deltarobotone/conveyor_system/Drawings/PNG/CarryFront.png

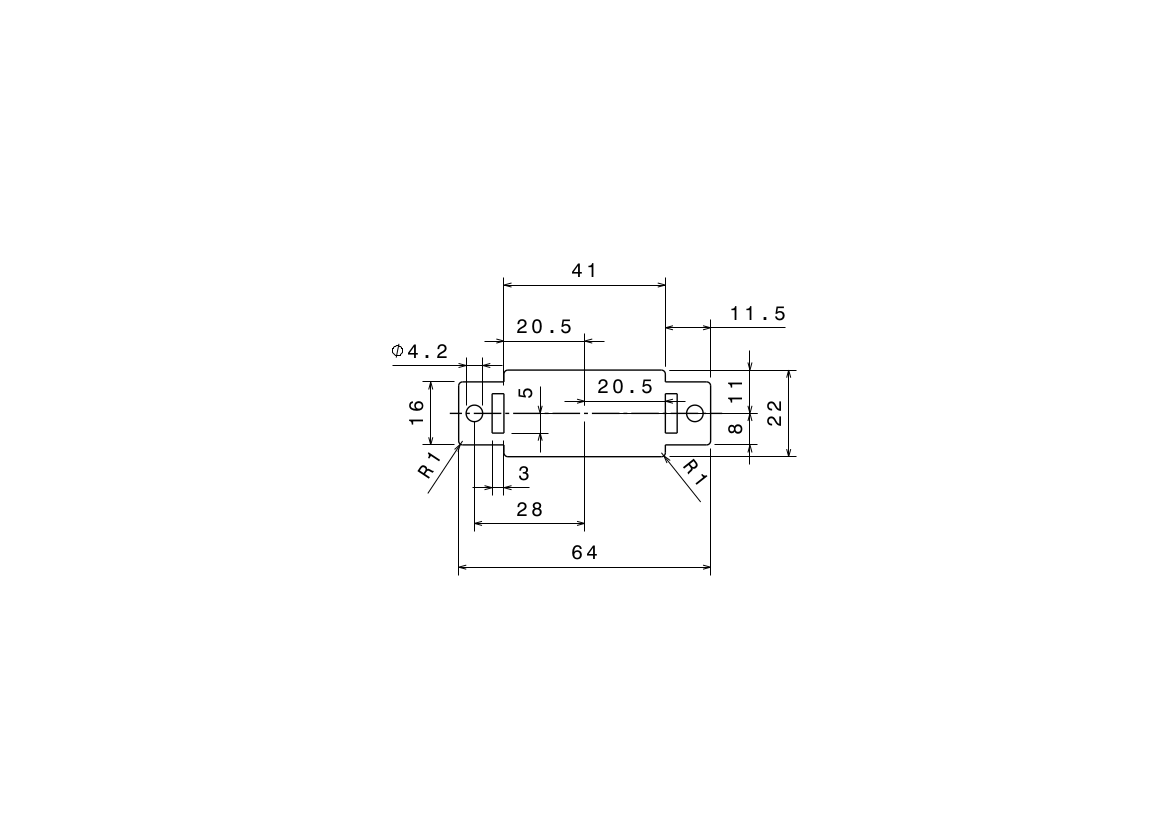
Drawings/PNG/CarryFront.png
