deltarobotone/conveyor_system/Drawings/PNG/CarrySide.png

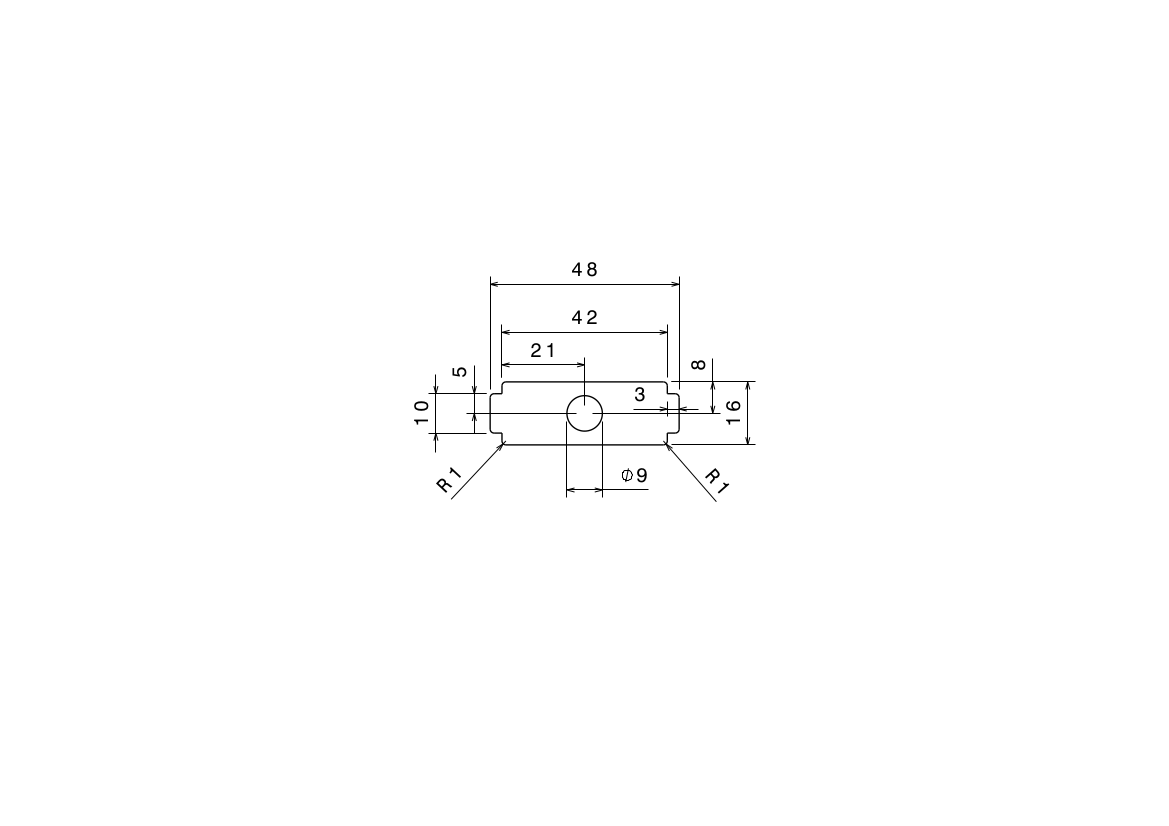
Drawings/PNG/CarrySide.png
