deltarobotone/conveyor_system/Drawings/PNG/ConveyorLayer_1.png

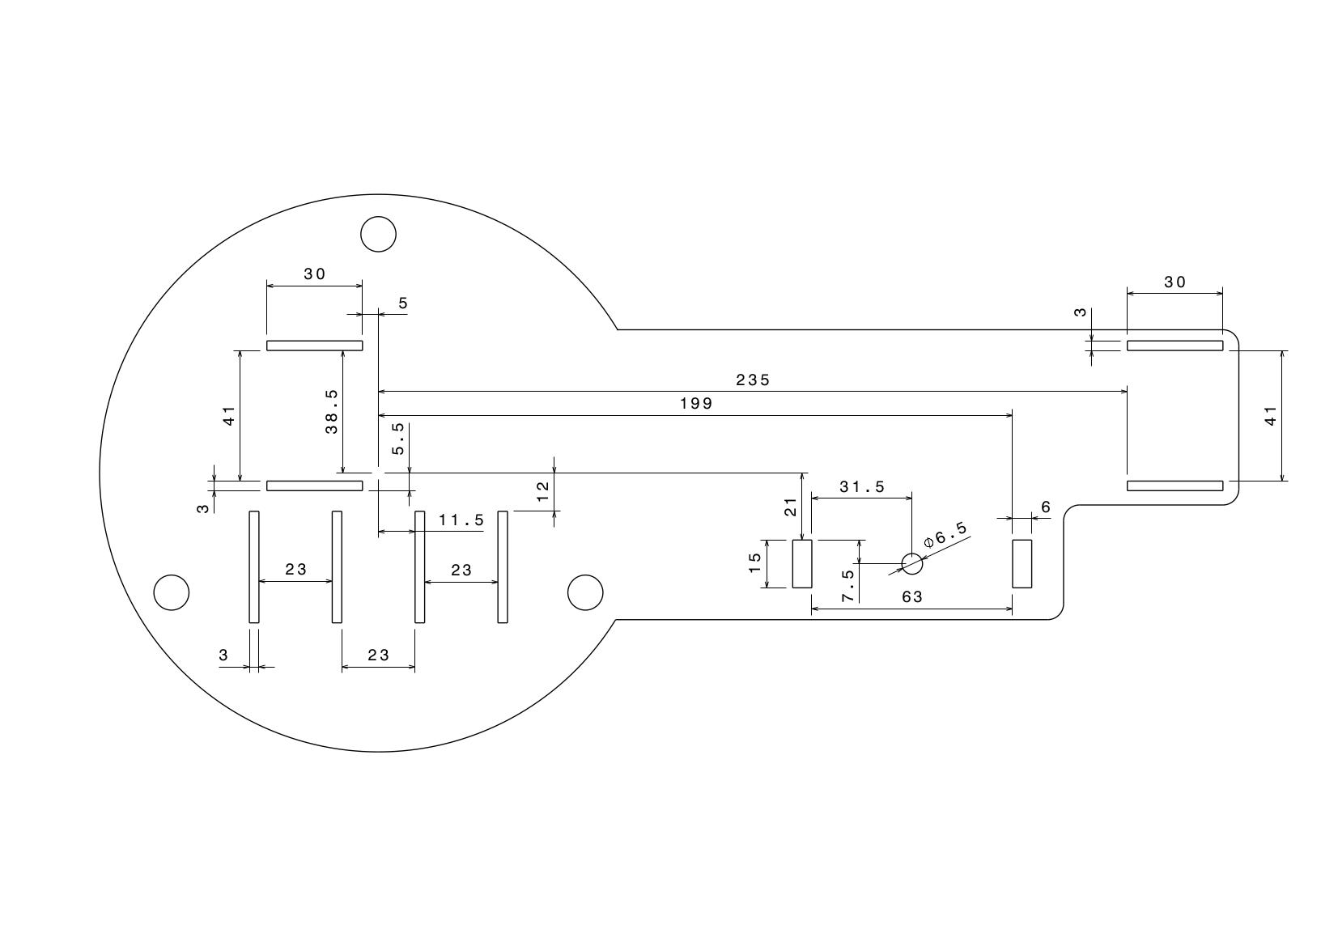
Drawings/PNG/ConveyorLayer_1.png
