deltarobotone/conveyor_system/Drawings/PNG/ConveyorLayer_2.png

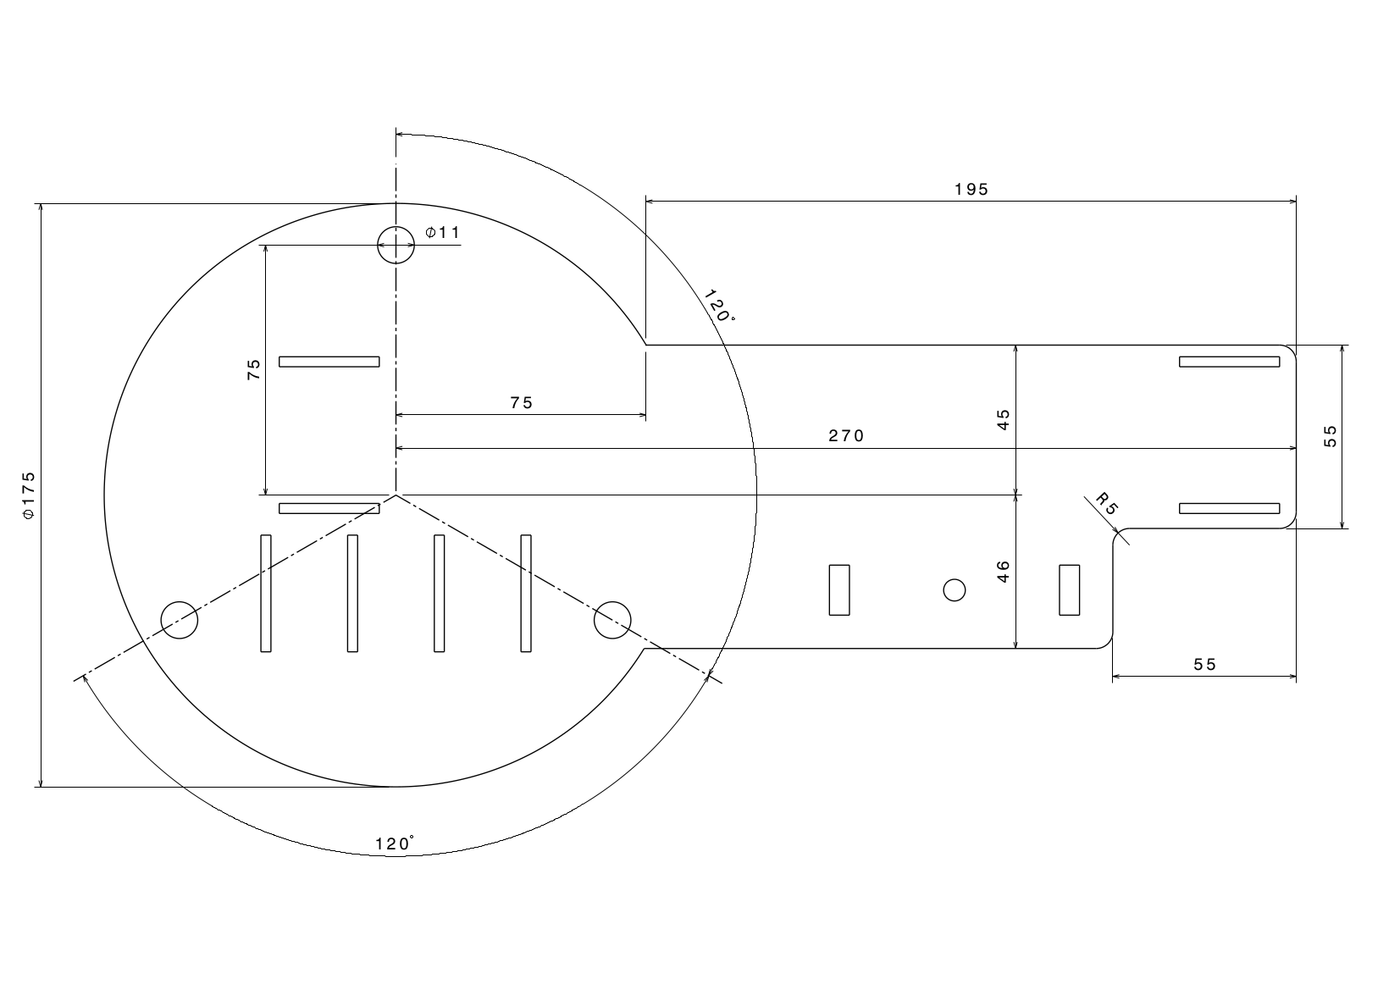
Drawings/PNG/ConveyorLayer_2.png
