deltarobotone/conveyor_system/Drawings/PNG/Drum.png

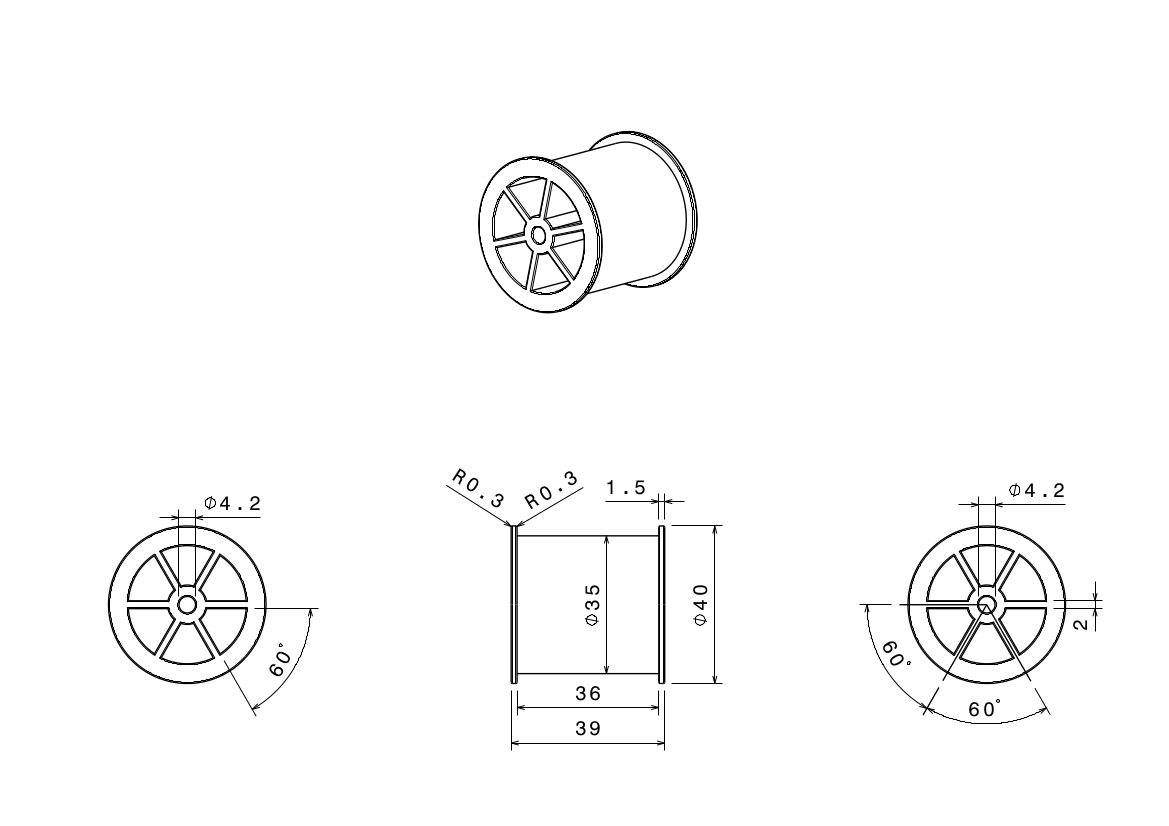
Drawings/PNG/Drum.png
