deltarobotone/conveyor_system/Drawings/PNG/DrumDrive.png

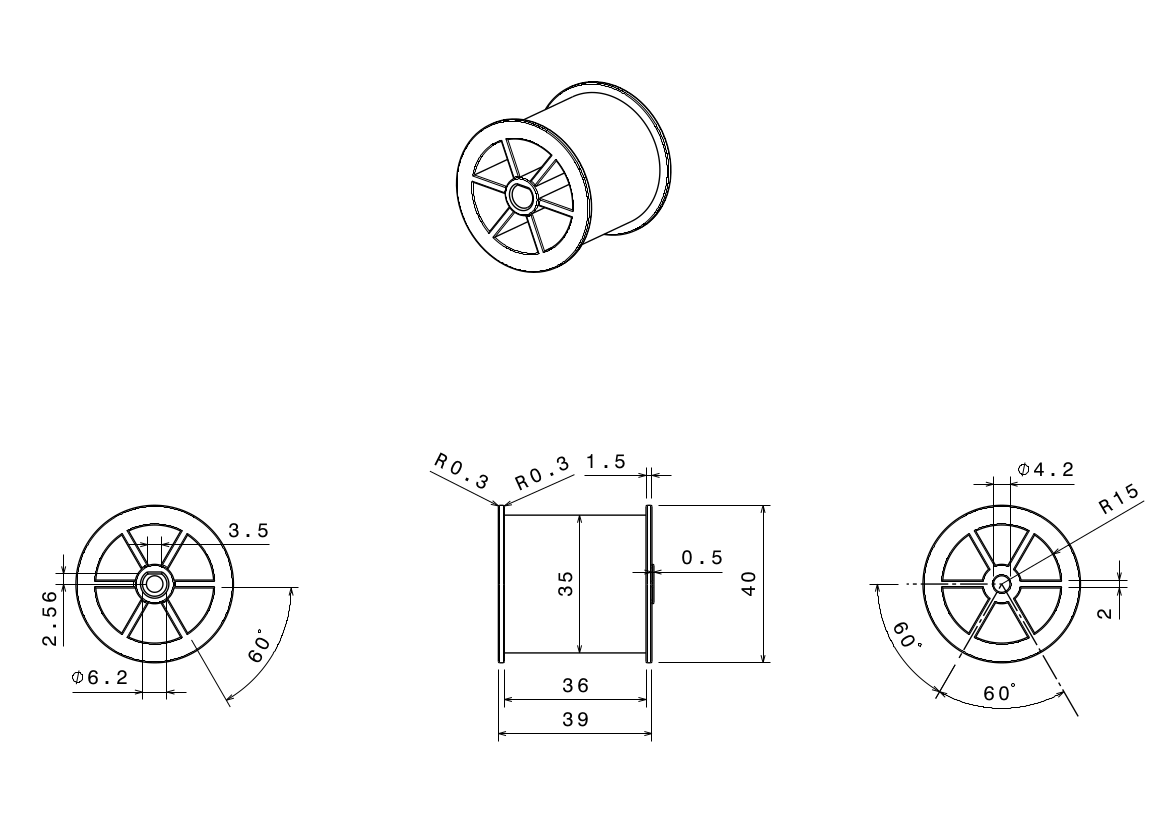
Drawings/PNG/DrumDrive.png
