deltarobotone/conveyor_system/Drawings/PNG/FrameDriveSide_1.png

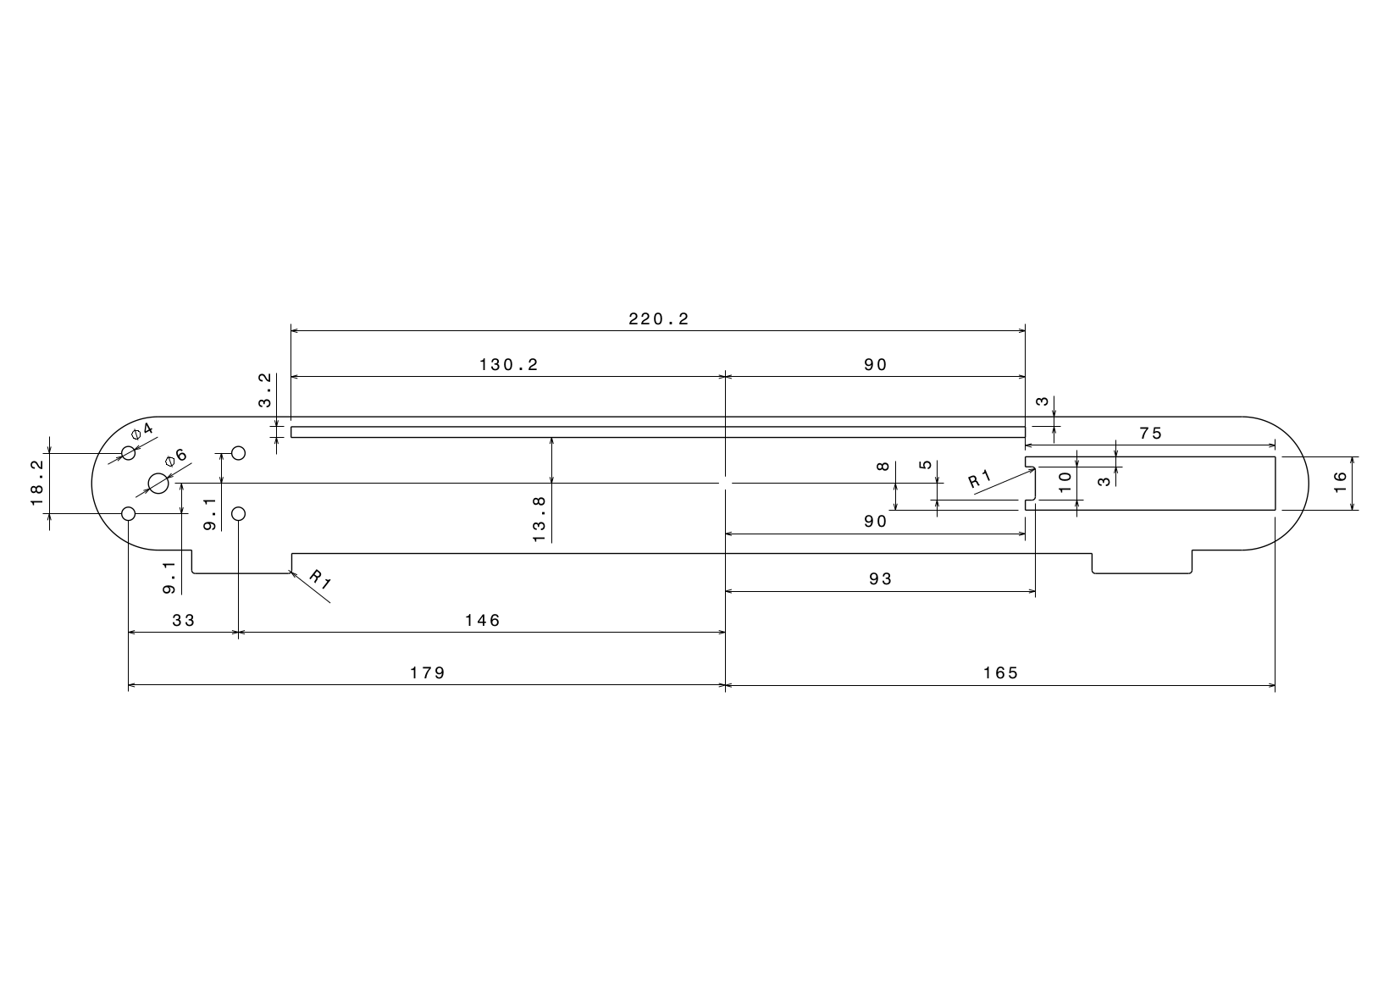
Drawings/PNG/FrameDriveSide_1.png
