deltarobotone/conveyor_system/Drawings/PNG/FrameDriveSide_2.png

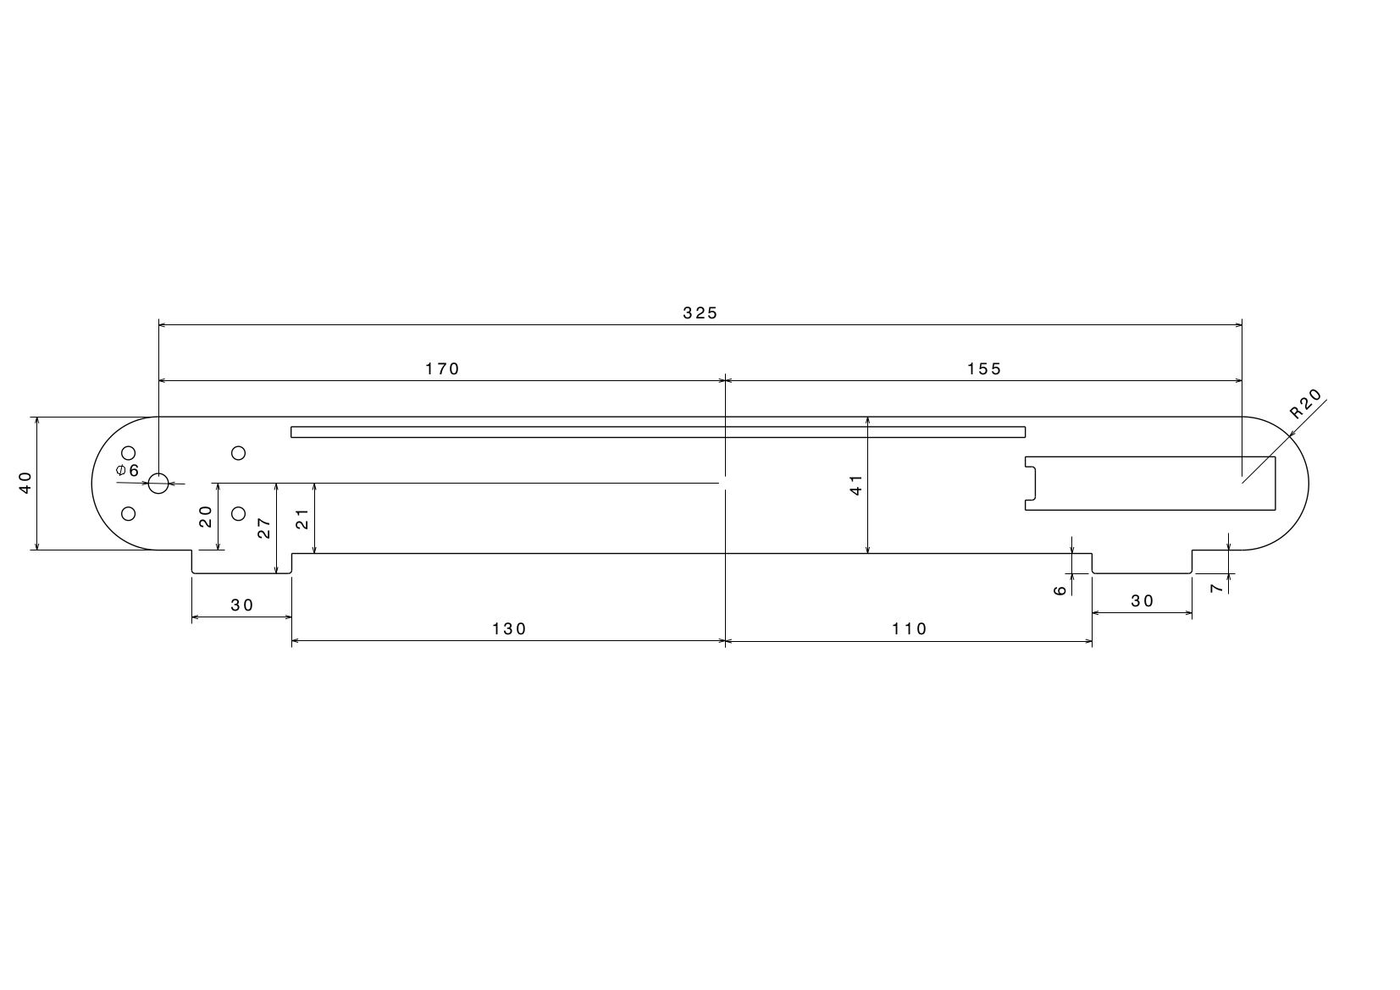
Drawings/PNG/FrameDriveSide_2.png
