deltarobotone/conveyor_system/Drawings/PNG/FrameSide_1.png

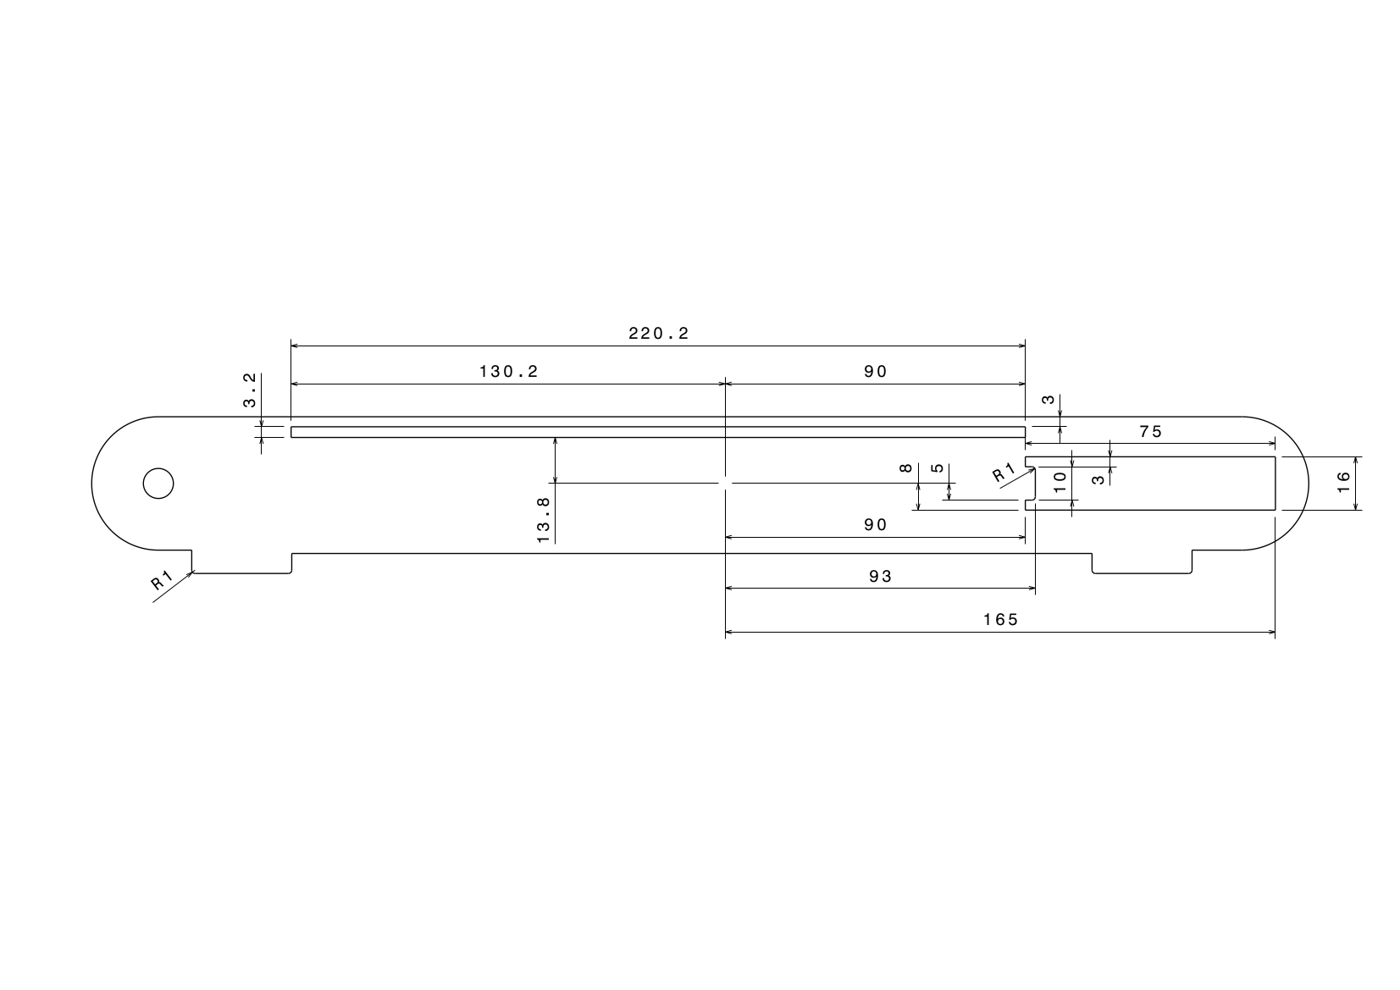
Drawings/PNG/FrameSide_1.png
