deltarobotone/conveyor_system/Drawings/PNG/FrameTop.png

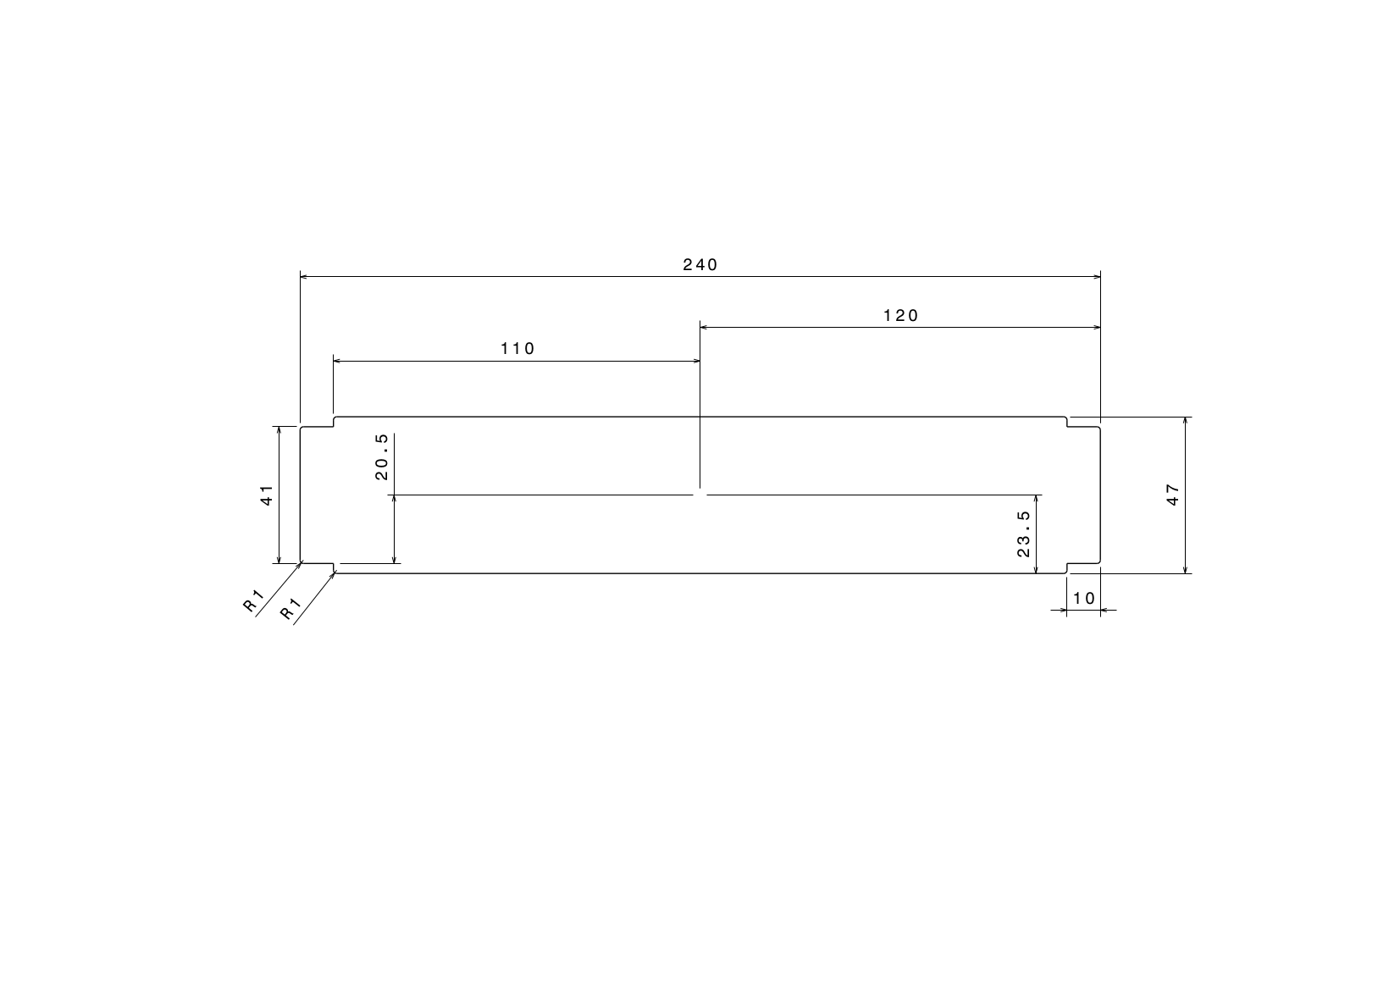
Drawings/PNG/FrameTop.png
