deltarobotone/conveyor_system/Drawings/PNG/Wall.png

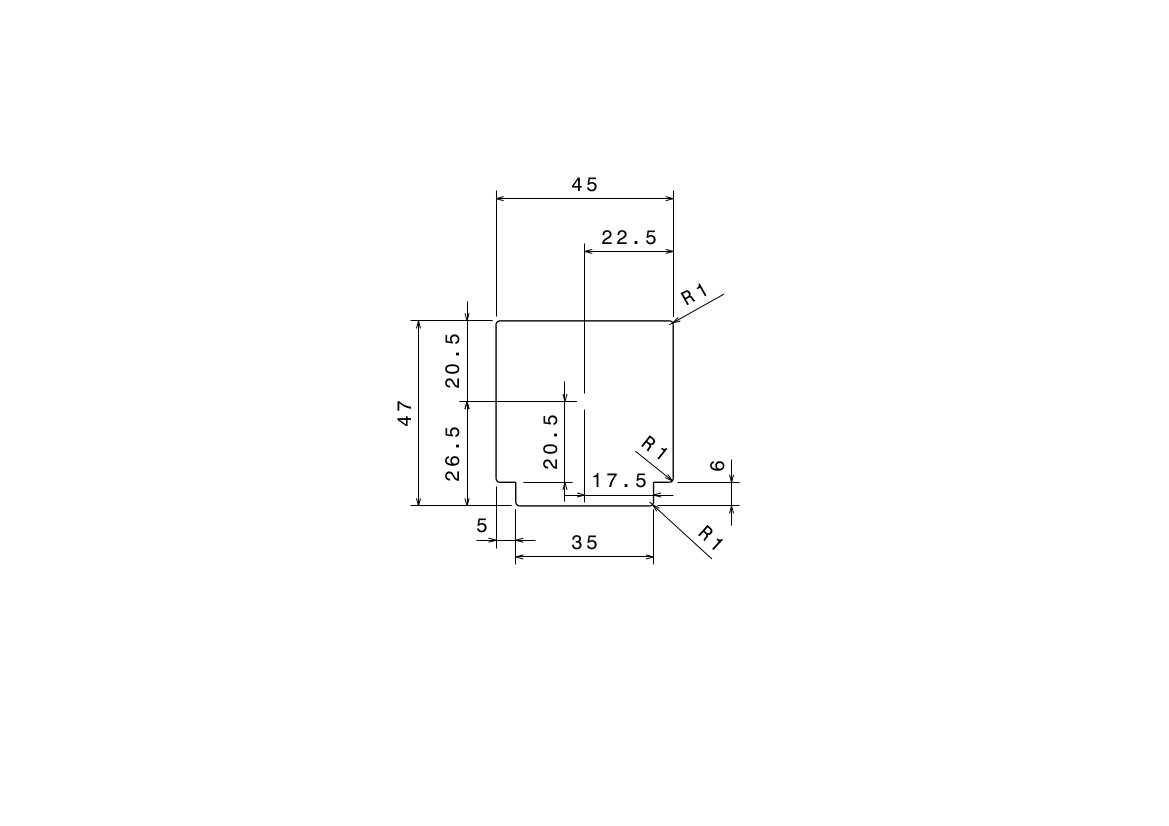
Drawings/PNG/Wall.png
