deltarobotone/conveyor_system/Drawings/PDF/CarryFront.pdf

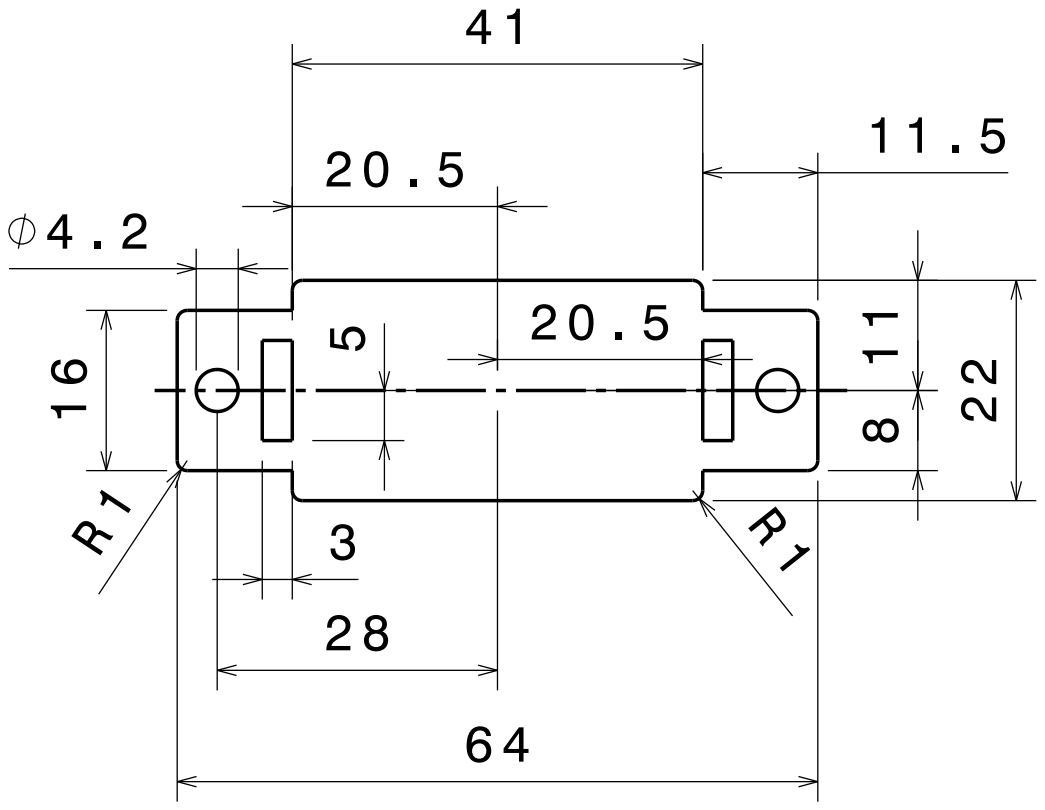
[picture p20: page 1]
