deltarobotone/conveyor_system/Drawings/PDF/CarrySide.pdf

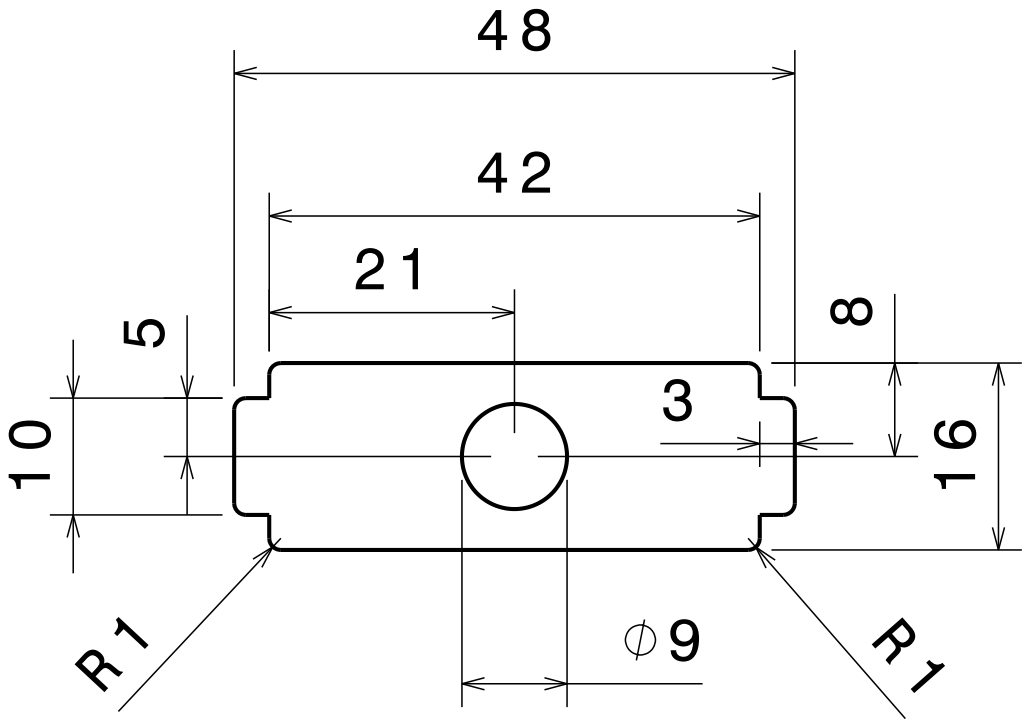
[picture p21: page 1]
