deltarobotone/conveyor_system/Drawings/PDF/ConveyorLayer_1.pdf

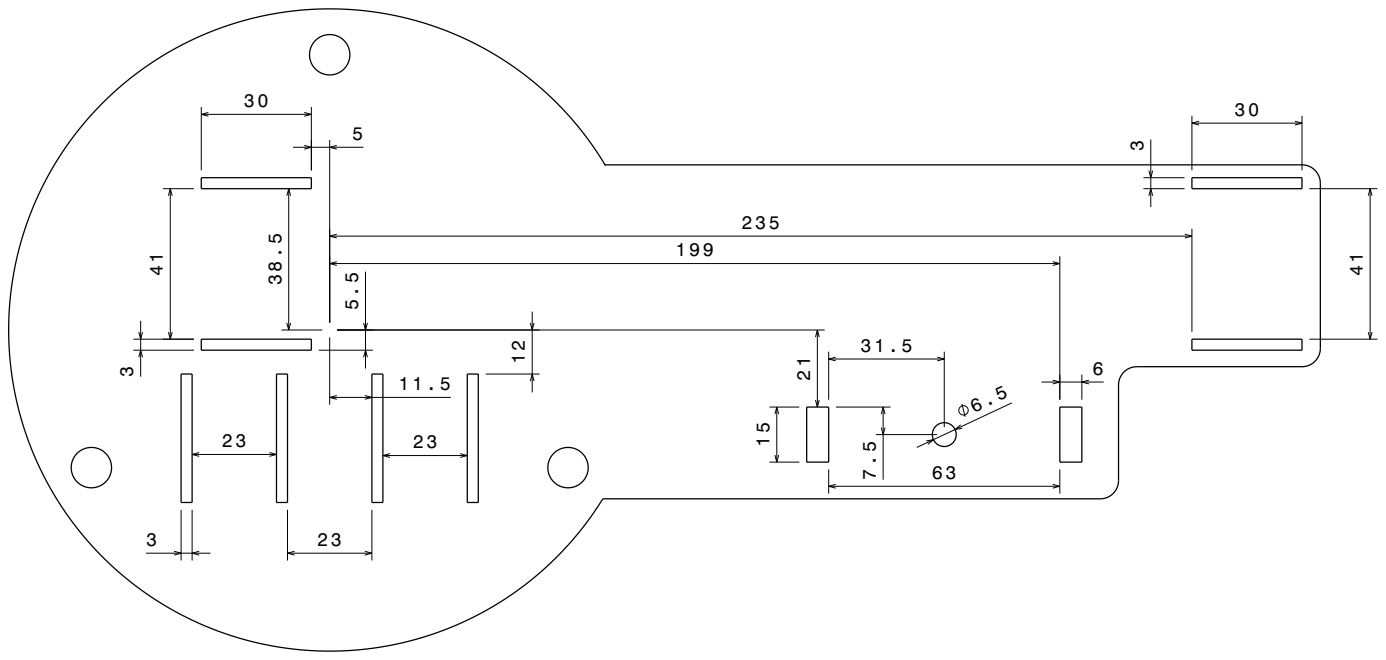
[picture p22: page 1]
