deltarobotone/conveyor_system/Drawings/PDF/ConveyorLayer_2.pdf

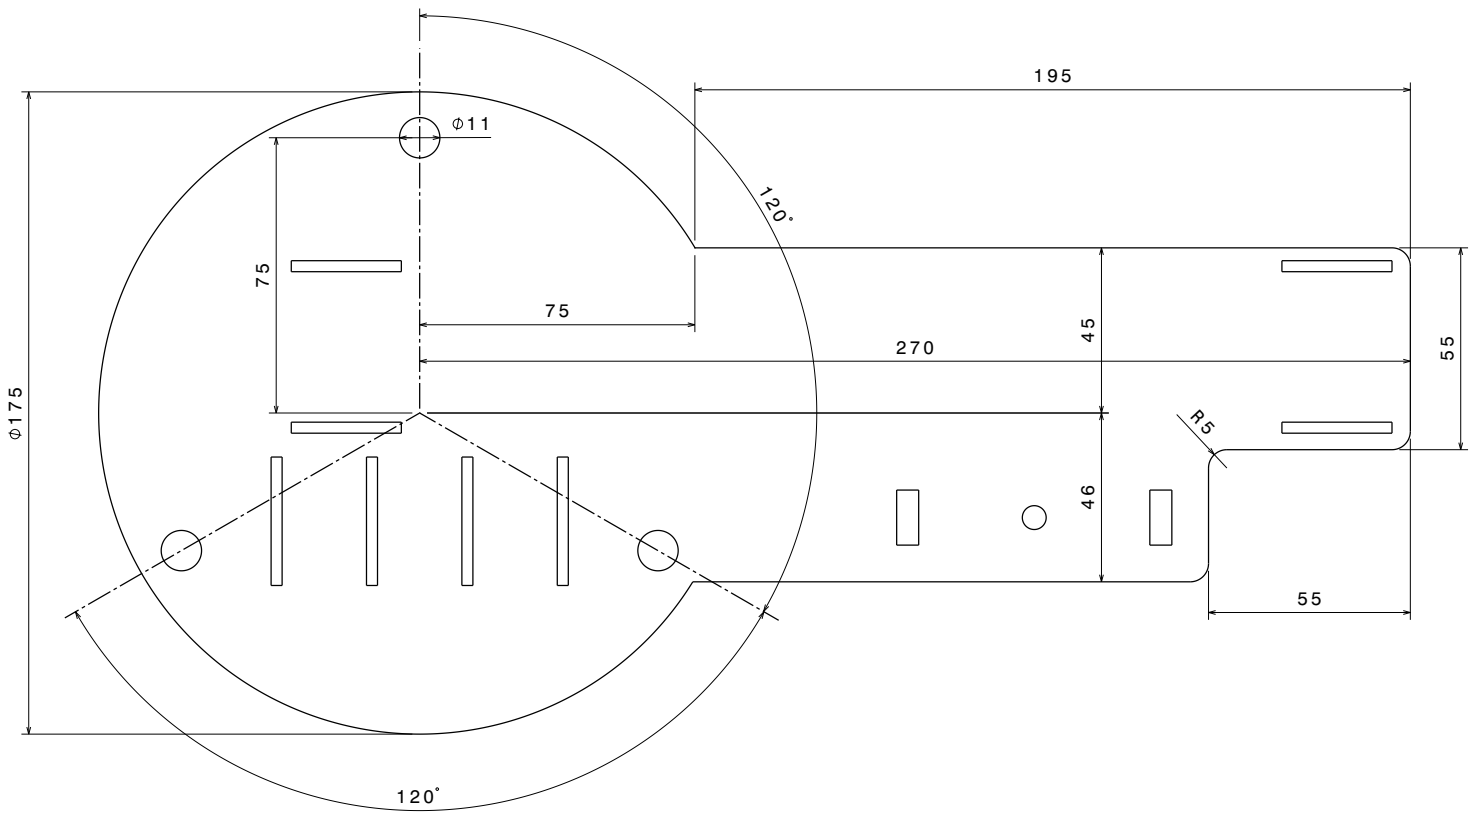
[picture p23: page 1]
