deltarobotone/conveyor_system/Drawings/PDF/Drum.pdf

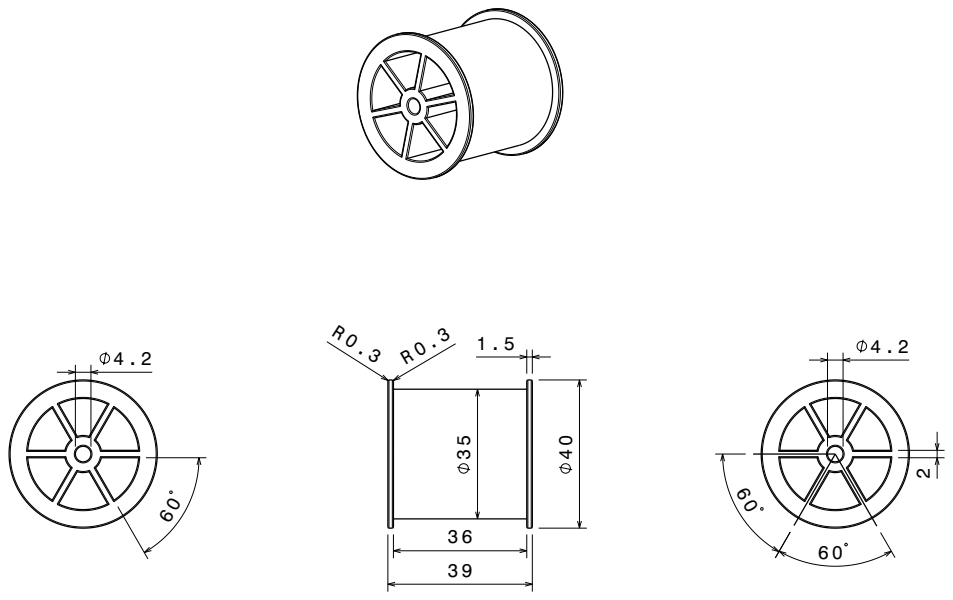
[picture p24: page 1]
