deltarobotone/conveyor_system/Drawings/PDF/DrumDrive.pdf

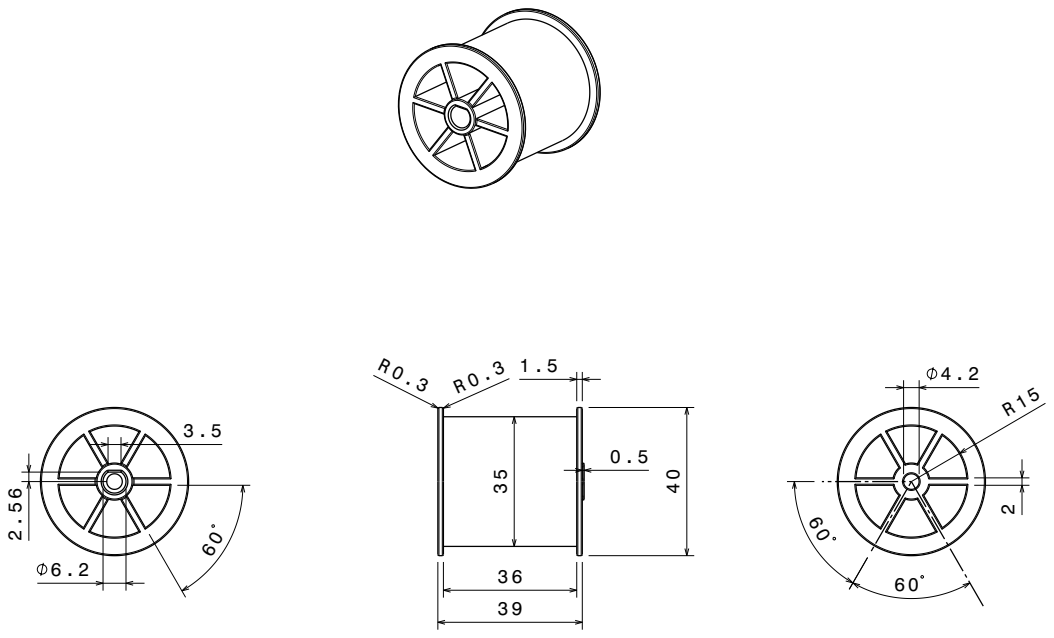
[picture p25: page 1]
