deltarobotone/conveyor_system/Drawings/PDF/FrameDriveSide_1.pdf

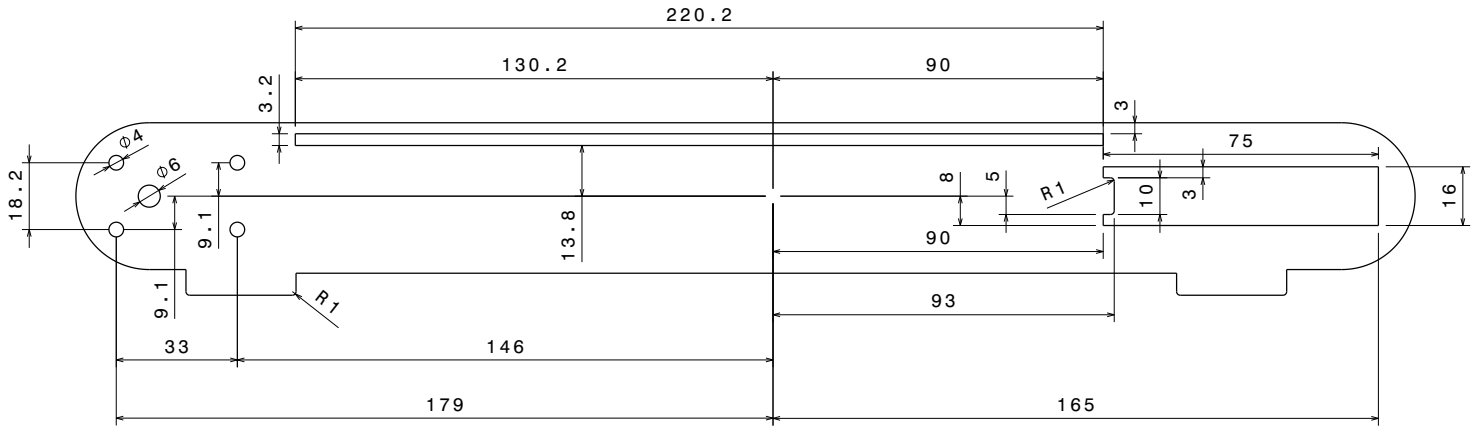
[picture p26: page 1]
