deltarobotone/conveyor_system/Drawings/PDF/FrameDriveSide_2.pdf

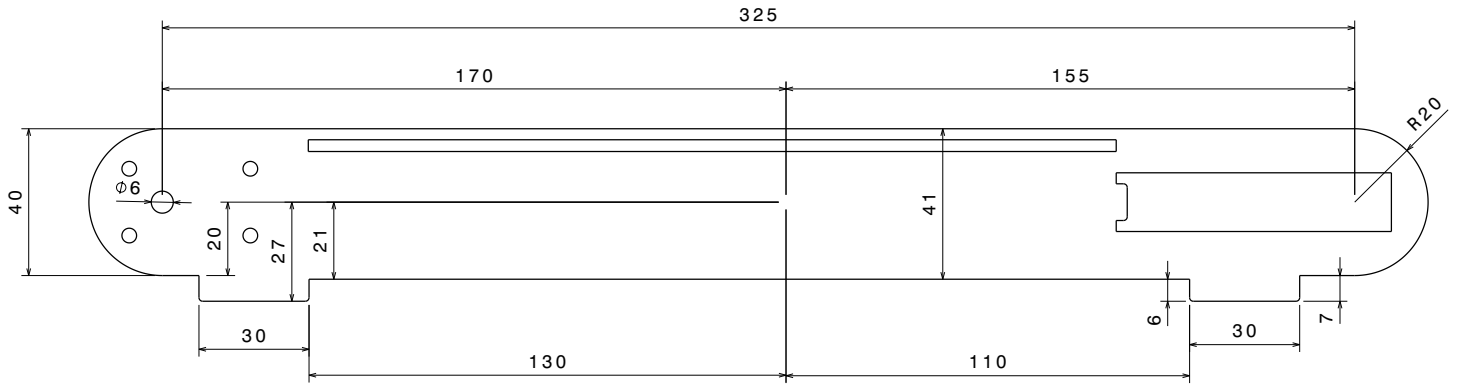
[picture p27: page 1]
