deltarobotone/conveyor_system/Drawings/PDF/FrameSide_1.pdf

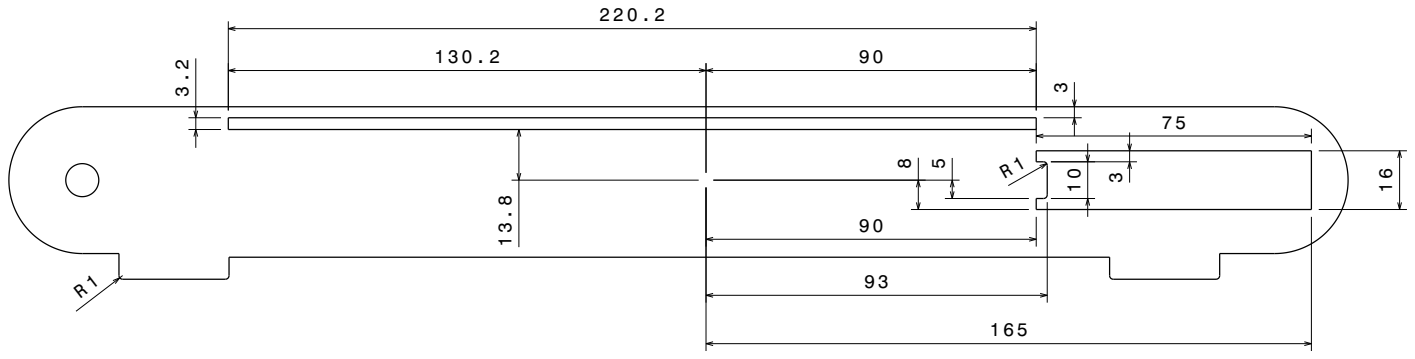
[picture p28: page 1]
