deltarobotone/conveyor_system/Drawings/PDF/FrameSide_2.pdf

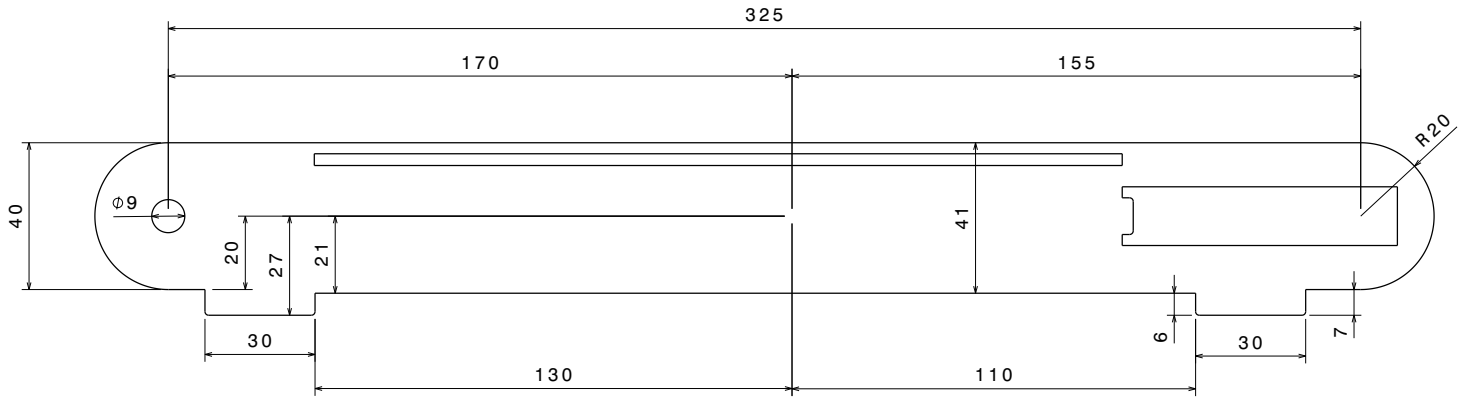
[picture p29: page 1]
