deltarobotone/conveyor_system/Drawings/PDF/FrameTop.pdf

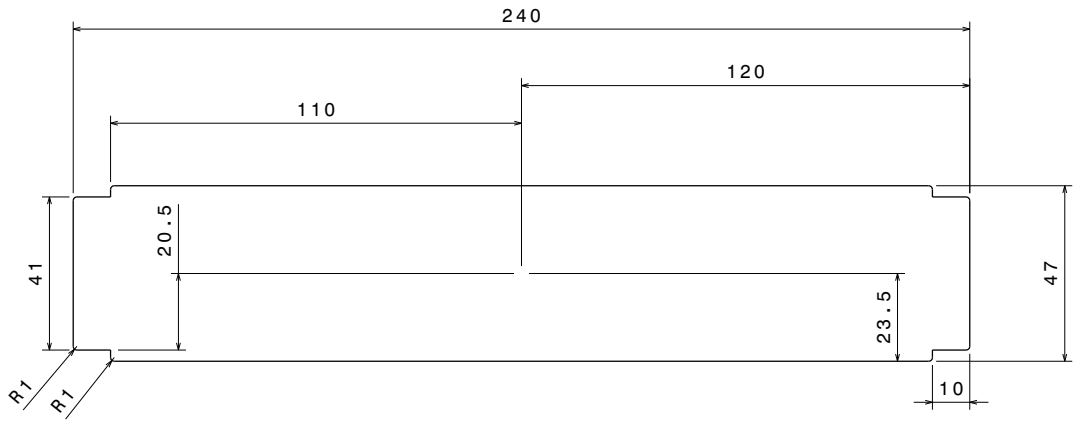
[picture p30: page 1]
