deltarobotone/conveyor_system/Drawings/PDF/Wall.pdf

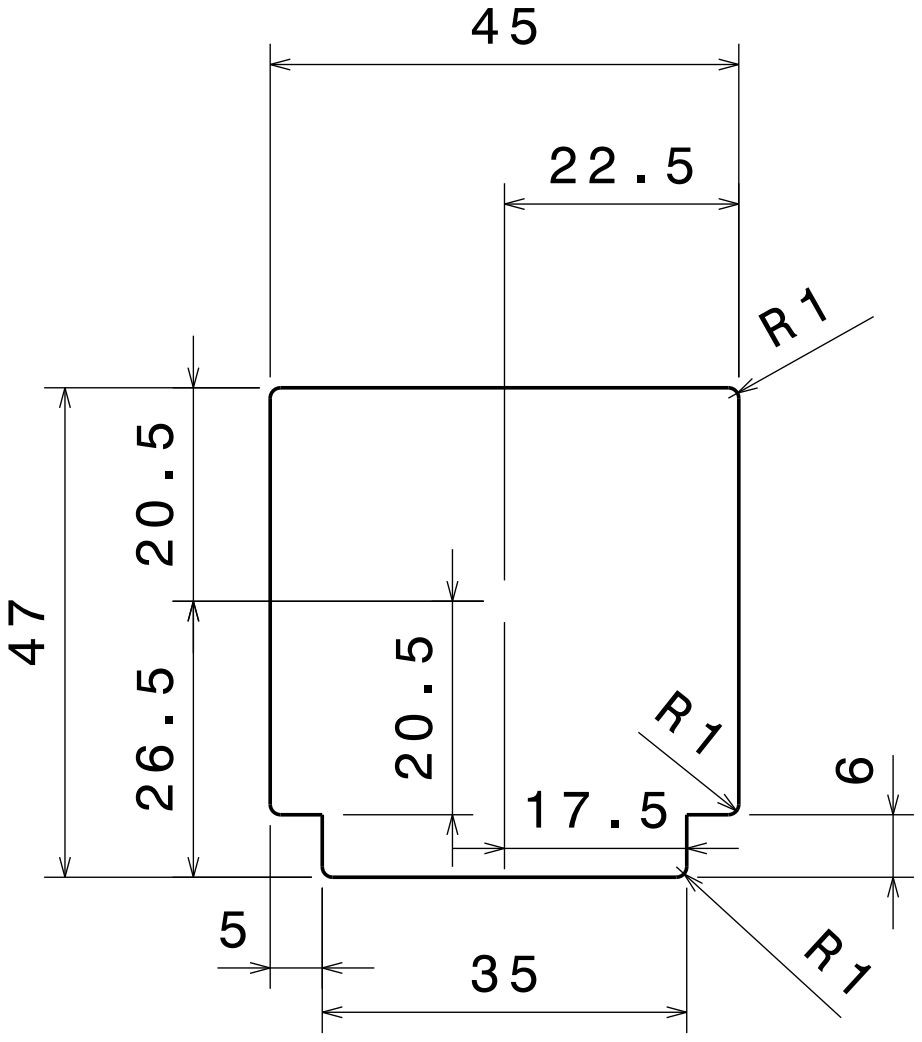
[picture p31: page 1]
