deltarobotone/conveyor_system/Lasercut/PDF/0_Conveyor_Layer_6mm.pdf

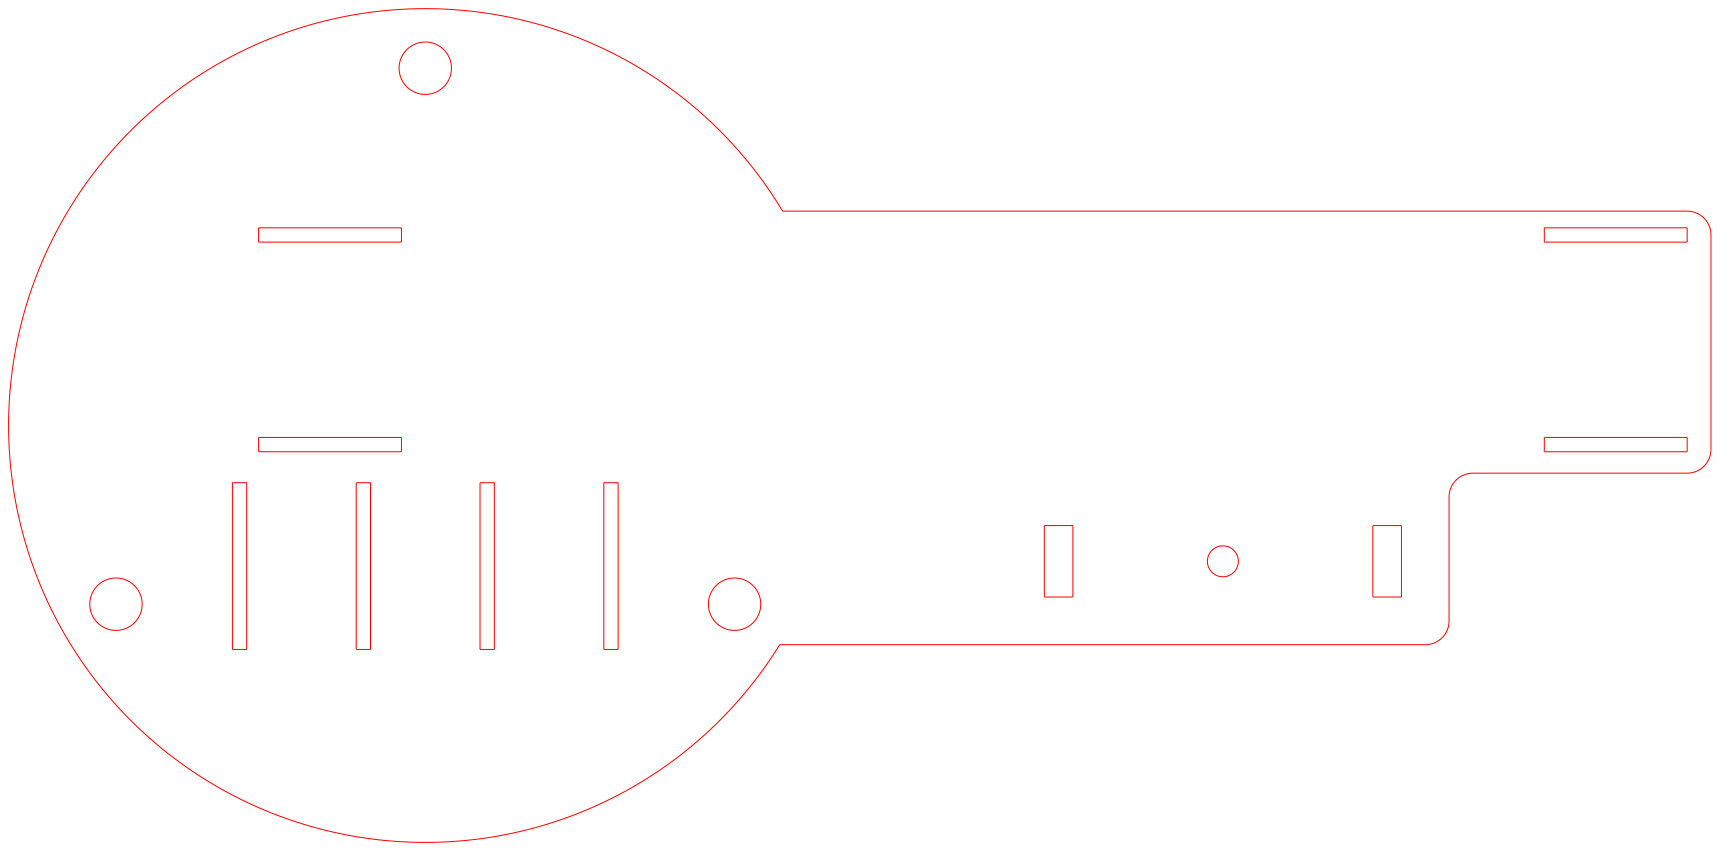
[picture p32: page 1]
