deltarobotone/conveyor_system/Lasercut/PDF/1_Frame_Side_3mm.pdf

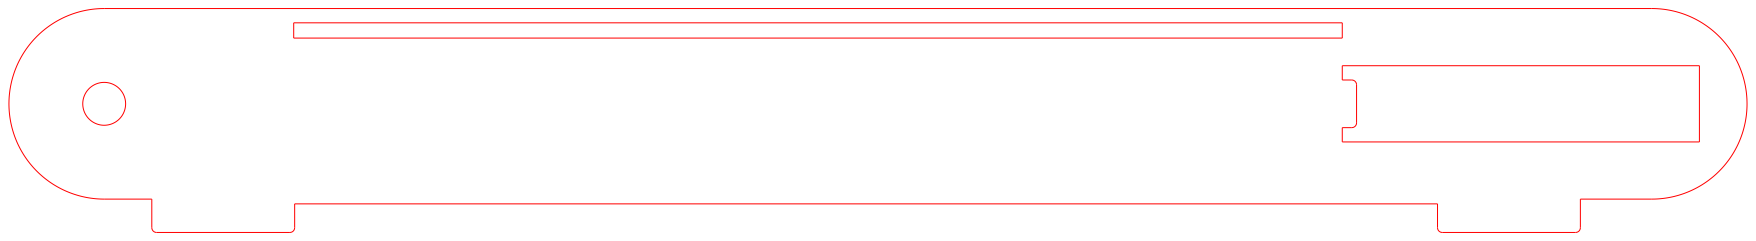
[picture p33: page 1]
