deltarobotone/conveyor_system/Lasercut/PDF/2_Frame_Drive_Side_3mm.pdf

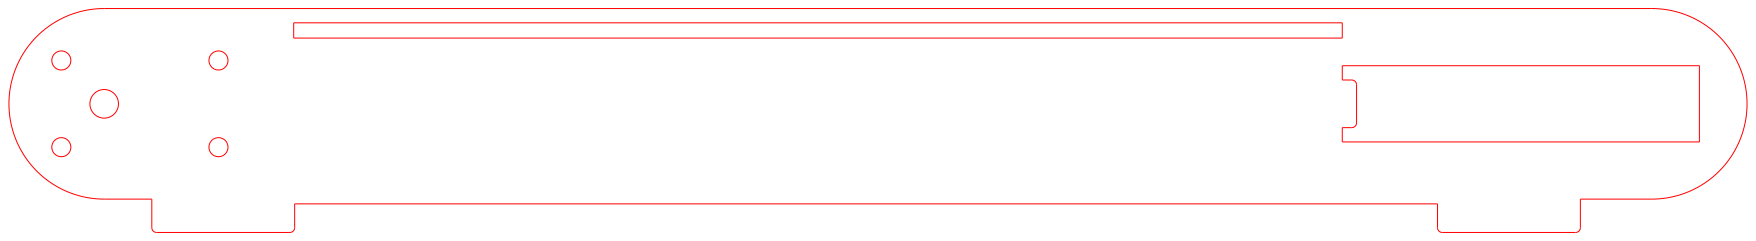
[picture p34: page 1]
