deltarobotone/conveyor_system/Lasercut/PDF/3_Frame_Top_3mm.pdf

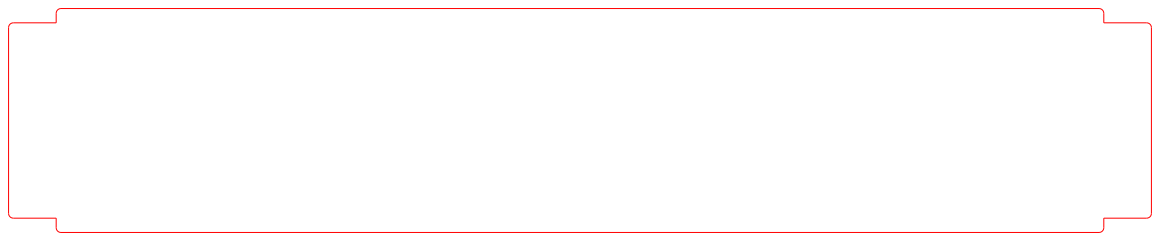
[picture p35: page 1]
