deltarobotone/conveyor_system/Lasercut/PDF/4_Carry_Front_3mm.pdf

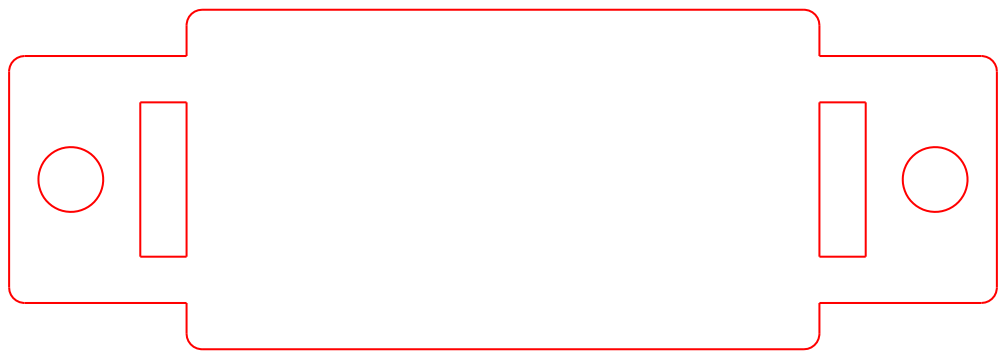
[picture p36: page 1]
