deltarobotone/conveyor_system/Lasercut/PDF/5_Carry_Side_3mm.pdf

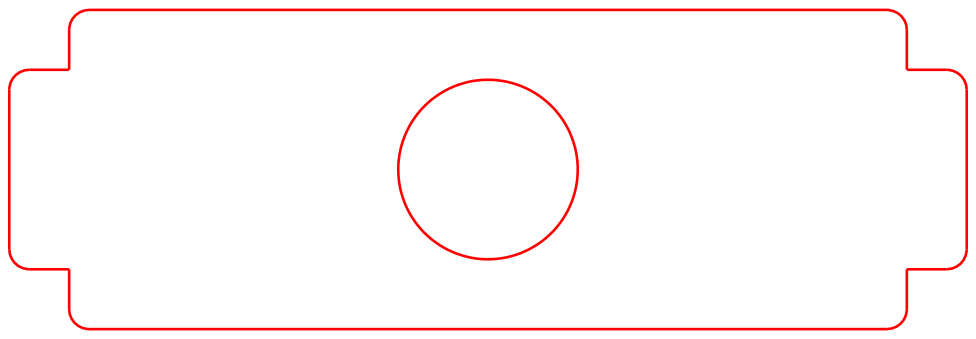
[picture p37: page 1]
