deltarobotone/conveyor_system/Lasercut/PDF/6_Wall_3mm.pdf

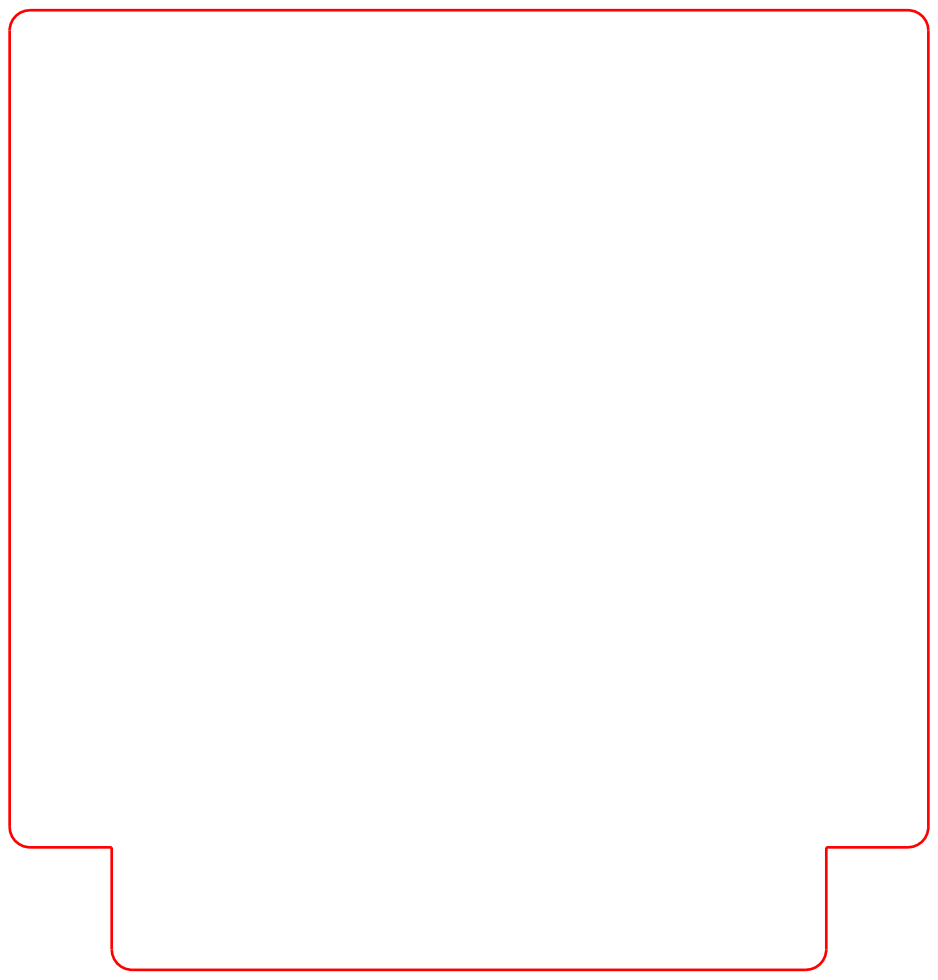
[picture p38: page 1]
