deltarobotone/conveyor_system/3D_Print/Drums/Drum.stl

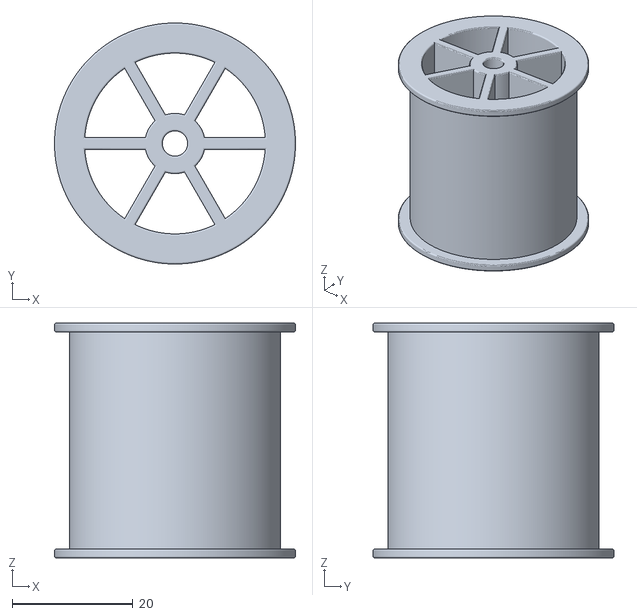
[picture p12: CAD file, 2020-04-07]
3D_Print/Drums/Drum.stl
40.0 x 40.0 x 39.0
