deltarobotone/conveyor_system/Lasercut/STL/1_Frame_Side_3mm.stl

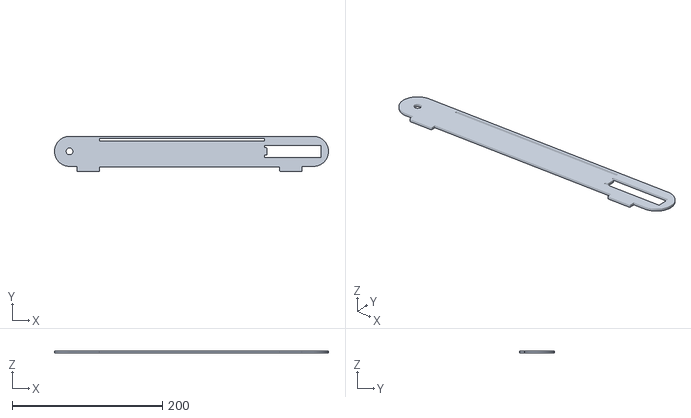
[picture p13: CAD file, 2020-04-07]
Lasercut/STL/1_Frame_Side_3mm.stl
365.0 x 47.0 x 3.00
