deltarobotone/conveyor_system/3D_Print/Drums/Drum_Drive.stl

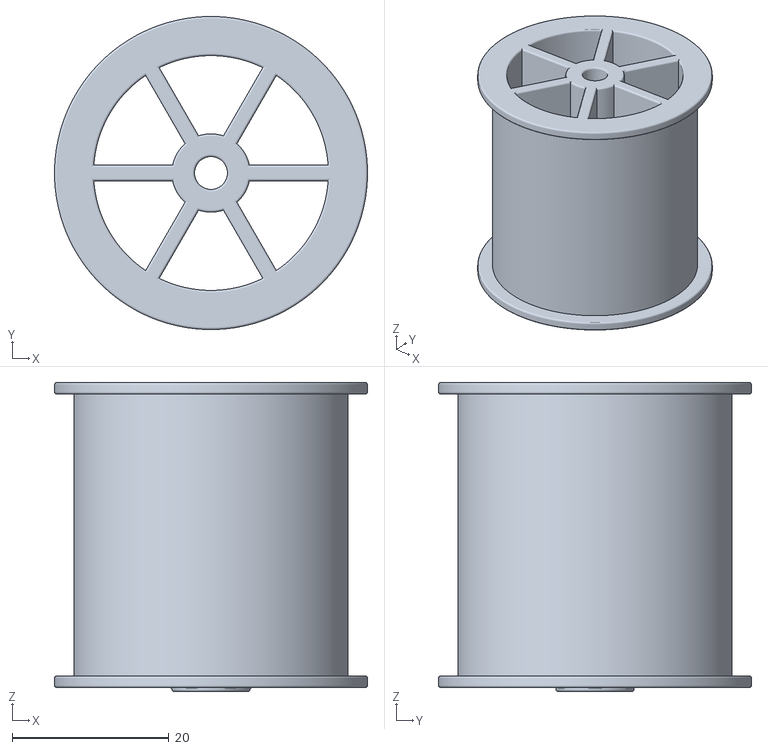
[picture p14: CAD file, 2020-04-07]
3D_Print/Drums/Drum_Drive.stl
40.0 x 40.0 x 39.5
