deltarobotone/conveyor_system/Lasercut/STL/0_Conveyor_Layer_6mm.stl

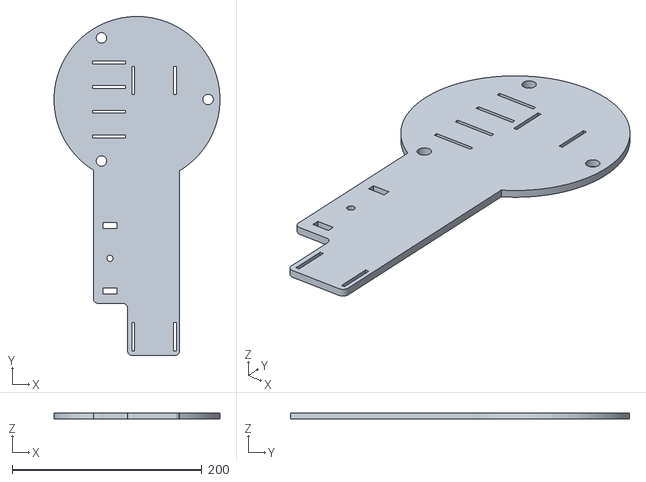
[picture p15: CAD file, 2020-04-07]
Lasercut/STL/0_Conveyor_Layer_6mm.stl
175.0 x 357.5 x 6.00
