deltarobotone/conveyor_system/Lasercut/STL/4_Carry_Front_3mm.stl

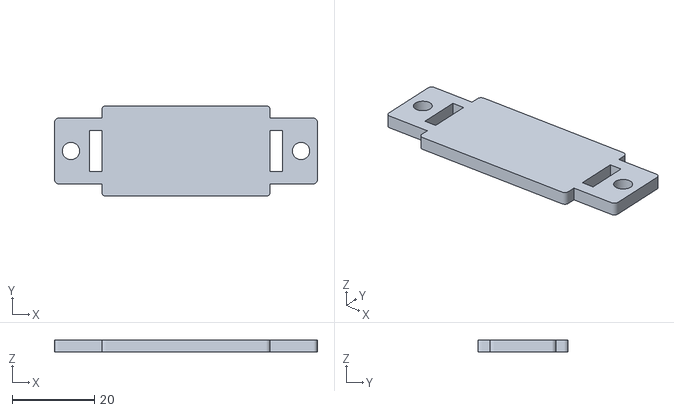
[picture p16: CAD file, 2020-04-07]
Lasercut/STL/4_Carry_Front_3mm.stl
64.0 x 22.0 x 3.00
