deltarobotone/conveyor_system/Lasercut/STL/6_Wall_3mm.stl

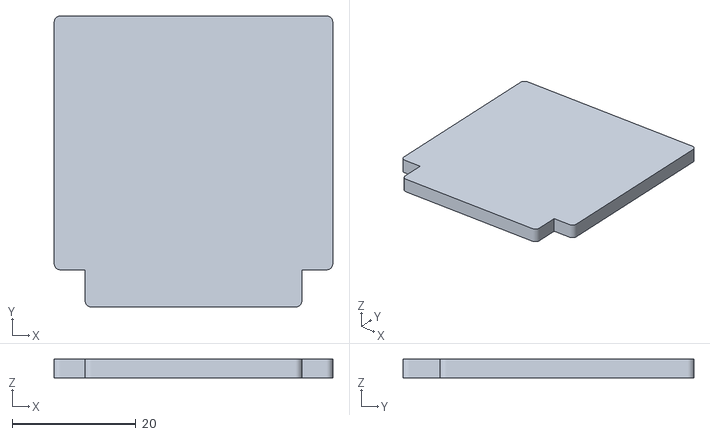
[picture p17: CAD file, 2020-04-07]
Lasercut/STL/6_Wall_3mm.stl
45.0 x 47.0 x 3.00
