deltarobotone/conveyor_system/Lasercut/STL/5_Carry_Side_3mm.stl

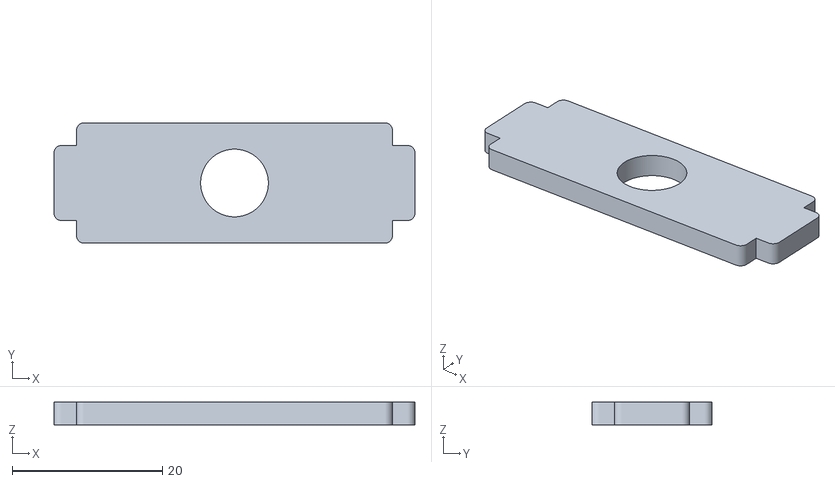
[picture p18: CAD file, 2020-04-07]
Lasercut/STL/5_Carry_Side_3mm.stl
48.0 x 16.0 x 3.00
