deltarobotone/conveyor_system/Lasercut/STL/3_Frame_Top_3mm.stl

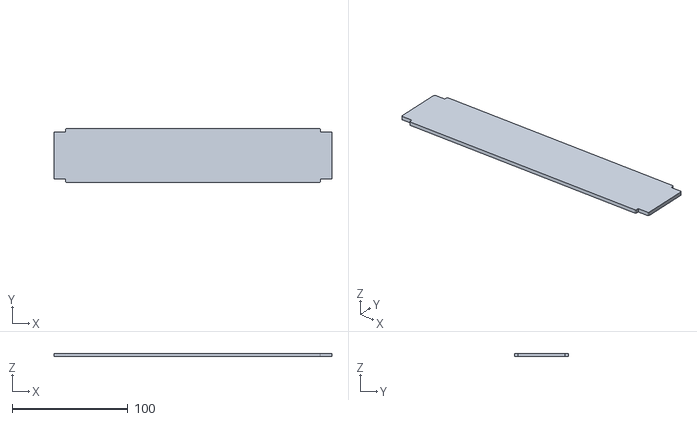
[picture p19: CAD file, 2020-04-07]
Lasercut/STL/3_Frame_Top_3mm.stl
240.0 x 47.0 x 3.00
