deltarobotone/conveyor_system/(list of files, cad)

Other CAD files:
Lasercut/STL/2_Frame_Drive_Side_3mm.stl
Lasercut/DXF/0_Conveyor_Layer_6mm.dxf
Lasercut/DXF/1_Frame_Side_3mm.dxf
Lasercut/DXF/2_Frame_Drive_Side_3mm.dxf
Lasercut/DXF/3_Frame_Top_3mm.dxf
Lasercut/DXF/4_Carry_Front_3mm.dxf
Lasercut/DXF/5_Carry_Side_3mm.dxf
Lasercut/DXF/6_Wall_3mm.dxf
